liminal-still-exists/switch-bot-d1/NetworkInfo_EXAMPLE.ino

/* 아래 값들은 예시이며, 실제 네트워크 환경에 맞게 수정해야 합니다. */

// const char* ssid = "YOUR_WIFI_SSID";
// const char* password = "YOUR_WIFI_PASSWORD";

// IPAddress local_ip(192, 168, 1, 100);
// IPAddress gateway(192, 168, 1, 1);
// IPAddress subnet(255, 255, 255, 0);
